Nizamovpl/FunctionGeneratorCircuts/README.md

# FunctionGeneratorCircuts
Final Project PHYS 3330

Here are the circuts needed for our funciton generator
