Nizamovpl/FunctionGeneratorCircuts/Triangle_wave_addition.asc

C1: cap; 1�
C6: cap; 1�F
R1: res; 10k
R2: res; 10k
R3: res; 10k
R_3: res; 10k
U1: OP07
U2: OP07
V1: voltage; 5
V2: voltage; 5
Named nets: +Vcc, -Vcc, 0, Vsquare, Vtriangle
.tran 0 50m 0 1u startup
R_1 = R_2
Potentiometer
Can add this to any Square Wave Generator :)
