Nizamovpl/FunctionGeneratorCircuts/Square_wave_BJT.asc

C1: cap; 10nF
C2: cap; 10nF
Q1: npn
Q2: npn
R1: res; 2k
R2: res; 27k
R3: res; 27k
R4: res; 2k
V1: voltage; 10
Named nets: 0
.tran 0 50m 0
Potentiometer here???
