Nizamovpl/FunctionGeneratorCircuts/Square_wave_Op_Amp.asc

C6: cap; 1µF
R1: res; 10k
R2: res; 10k
R_3: res; 10k
U1: OP07
V1: voltage; 5
V2: voltage; 5
Named nets: +Vcc, -Vcc, 0, Vsquare
.tran 0 10m 0 1u startup
R_1 = R_2
Potentiometer
